VladCher-ger/MyKeyBoard/crkbd/cases/3x5/right.step

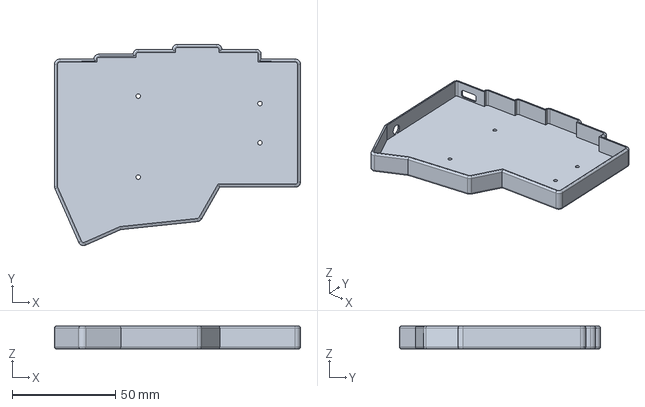
[picture p1: CAD file, 2025-06-12]
crkbd/cases/3x5/right.step
119.3 x 97.6 x 11.1 mm
