VladCher-ger/MyKeyBoard/crkbd/cases/3x6/left.step

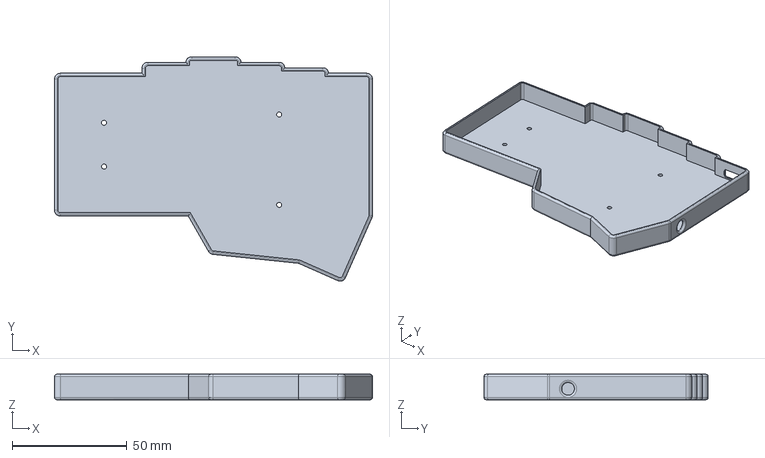
[picture p2: CAD file, 2025-06-12]
crkbd/cases/3x6/left.step
138.3 x 97.6 x 11.1 mm
