VladCher-ger/MyKeyBoard/output/outlines/left.dxf

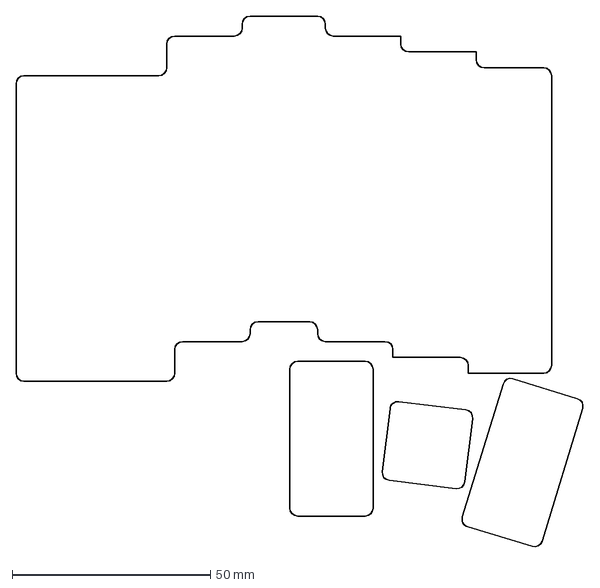
[picture p3: CAD file, 2025-06-10]
output/outlines/left.dxf
143.2 x 134.0 mm
