VladCher-ger/MyKeyBoard/(list of files, cad)

Other CAD files:
crkbd/cases/3x5/left.step
crkbd/cases/3x6/right.step
