VladCher-ger/MyKeyBoard/crkbd/docs/corne-cherry/v4/buildguide_jp.md

# Build Guide
こちらは Corne Cherry v4 のビルドガイドになります。

corne-v4-cherry

## Parts

### Required

| Name | Count | Remarks |
|:---|:---|:---|
| PCB | 1 set | |
| Case | 1 set | |
| Switch plate | 1 set | FR4 厚さ 1.6mm |
| Key switches | 42 - 46 | Cherry MX 互換のみ |
| Keycaps | 42 - 46 | 1u 40 pcs, 1.5u 2 pcs |
| Spacer M2 | 8 | 長さ 7.5 mm |
| Screw M2 | 16 | 長さ 5 mm |
| Rubber cushion | 8 | |
| TRRS (4 poles) cable | 1 | v4.0.0: TRS (3 poles) は非対応<br/> v4.1.0: TRS (3 poles) に対応 |
| Type-C cable | 1 | |

### Optional

| Name | Count | Remarks |
|:---|:---|:---|
| Rotary Encoder | 0 - 4 pieces | EC12互換  |

## Firmware preparation
[docs/firmware/rev4](../../firmware/rev4/firmware_jp.md) を参照してください。

## Build
これは左手側のビルドガイドですが、右手側も手順は同じです。

### 1: キースイッチを取り付ける
plate
plate-side

### オプション: キースイッチの代わりにロータリーエンコーダをはんだ付けする
ロータリーエンコーダを使う場合、下記の図の位置にキースイッチの代わりにロータリーエンコーダを付けることができます。その場合は、裏側からはんだ付けが必要です。

rotary-encoder

### 2: ケースにスペーサーを付ける
case

### 3: 1と2を組み合わせる
switch+case

### 4: ラバークッションを取り付ける
rubber-cushion

### 5: キーキャップを取り付ける
keycap

## 注意
USBケーブルが刺さっている状態でTRRSケーブルの抜き差しが行われると、キーボードのマイコンが破壊されることがあります。  
TRRSケーブルを抜き差しする際は、USBケーブルが外れていることを確認してから行うようにしてください。
