VladCher-ger/MyKeyBoard/crkbd/docs/corne-cherry/v2/buildguide_tilting_tenting_plate_en.md

# Build Guide Tilting / Tenting plate

## Parts

| Name | Count | Remarks |
|:-|:-|:-|
| Completed Corne Cherry | 1 set | Corne Chocolate / 3mm top plate is not supported |
| Middle plate 3mm | 2 sheets | |
| Bottom plate 3mm | 2 sheets | |
| Bolt M5 15mm ~ 50mm | 8 bolts | |
| Nut M5 | 16 pieces | |
| Screw M2 6mm | 10 screws | |
| Screw M2 4mm | 10 screws | |
| Spacer M2 3.5mm | 10 pieces | |
| Cushion rubber | 8 pieces | |

## Advance preparation

lrg_dsc05736

Remove the key switch from the finished Corne Cherry
to separate the body from the top plate.
No other parts are needed.

## Assembly

lrg_dsc05737
lrg_dsc05739

Check the required parts.
Check the dedicated middle plate and bottom plate, and bolts of various lengths.
In addition, use screws, nuts, spacers, etc. (see the parts section for details).

lrg_dsc05742

Secure the middle plate to the top plate with 6mm screws and 3.5mm spacers.

lrg_dsc05744
Secure the OLED display protection plate with 4mm screws.

lrg_dsc05745

Secure the body and bottom plate with 4mm screws.

lrg_dsc05747

Insert an acrylic spacer between the middle plate
and the bottom plate and attach the bolts.

lrg_dsc05748

It is recommended to temporarily assemble the bolts
and adjust the height before completely fixing them with nuts.
Temporary assembly can be done easily by passing only one nut through the bolt.

lrg_dsc05749
lrg_dsc05750

It is completed by firmly fixing it so that it is sandwiched between nuts.

lrg_dsc05761
