VladCher-ger/MyKeyBoard/crkbd/docs/corne-light/v1/buildguide_en.md

# Build Guide

This is the Corne Light v1 build guide.

## Parts

<table>
<thead>
  <tr> <td width = "30%"> Name </td> <td width = "15%"> Count </td> <td> Remarks </td> </tr>
</header>
<tbody>
  <tr>
    <td> PCB </td>
    <td> 1 set </td>
    <td>
      PCB
    </td>
  </tr>
  <tr>
    <td> Top plate </td>
    <td> 2 sheets </td>
    <td>
      top-plates
    </td>
  </tr>
  <tr>
    <td> Bottom plate </td>
    <td> 2 sheets </td>
    <td rowspan = "2">
      bottom-plates
    </td>
  </tr>
  <tr>
    <td> ProMicro protective plate </td>
    <td> 2 sheets </td>
  </tr>
  <tr>
    <td> diode </td>
    <td> 42 </td>
    <td>
      diodes
    </td>
  </tr>
  <tr>
    <td> Spacer M2 7.5mm </td>
    <td> 10 </td>
    <td rowspan = "3">
      screws
    </td>
  </tr>
  <tr>
    <td> Spacer M2 9mm </td>
    <td> 4 </td>
  </tr>
  <tr>
    <td> Screw M2 4mm </td>
    <td> 28 </td>
  </tr>
  <tr>
    <td> TRRS jack </td>
    <td> 2 </td>
    <td rowspan = "3">
      jacks
    </td>
  </tr>
  <tr>
    <td> Reset switch </td>
    <td> 2 </td>
  </tr>
  <tr>
    <td> Rubber feet </td>
    <td> 8 </td>
  </tr>
  <tr>
    <td> ProMicro (with conthrough) </td>
    <td> 2 </td>
    <td>
      <a href="https://yushakobo.jp/shop/promicro-spring-pinheader/"> https://yushakobo.jp/shop/promicro-spring-pinheader/ </a>
    </td>
  </tr>
  <tr>
    <td> OLED module (with pin socket) </td>
    <td> 2 </td>
    <td>
      <a href="https://yushakobo.jp/shop/oled/"> https://yushakobo.jp/shop/oled/ </a>
    </td>
  </tr>
  <tr>
    <td> key switch </td>
    <td> 42 </td>
    <td> </td>
  </tr>
  <tr>
    <td> keycap </td>
    <td> 42 </td>
    <td> </td>
  </tr>
  <tr>
    <td> TRRS cable </td>
    <td> 1 </td>
    <td> TRS cable is also acceptable </td>
  </tr>
  <tr>
    <td> USB cable </td>
    <td> 1 </td>
    <td> </td>
  </tr>
</tbody>
</table>

## Advance preparation

If you build the firmware yourself,
it takes time to prepare the environment,
so it is recommended to start first. \
See [docs/firmware/rev1](../../firmware/rev1/firmware_en.md)
for more information.

## Implementation

### PCB disconnection

Check the front and back and separate the left and right PCBs
(the photo is the front).

assembly-pcb

This is a jig for bending the legs of a diode.
Separate it if necessary.

assembly-tool-of-diodes

* Some versions do not have a jig.

### Diodes

First, bend the legs of the reed type diode.

* You can clean it by bending it one by one as shown in the picture,
  but it is more efficient to bend multiple pieces at the same time
  while connected to the tape.

assembly-diodes-1

Attach the diode with the bent leg to the specified position.

assembly-diodes-2

The diode has an orientation and is installed as shown in the photo.

* All the diodes to be attached are in the same orientation.

assembly-diodes-3

You can attach it neatly by fixing it with masking tape.

assembly-diodes-4

Solder from the back side.

assembly-diodes-5

If you are fixing with masking tape,
cutting your legs to the limit like this will make soldering easier.

assembly-diodes-6

With 21 one-handed and two-handed he installs 42 diodes.

assembly-diodes-7

### TRRS jack, reset switch, pin socket

Install in the specified position.

* Install the right hand side in the same position
  (be careful of mistakes on the front and back).

assembly-jacks-resets-pinsockets-1

### ProMicro, OLED module

Install his ProMicro and his OLED module by referring to the [Helix Build Guide](
https://github.com/MakotoKurauchi/helix/blob/master/Doc/buildguide_en.md#pro-micro).

assembly-promicro-oled

### Firmware

Write the firmware to ProMicro by referring to the following. \
[docs/firmware/rev1](../../firmware/rev1/firmware_en.md)

### Operation check

To check the operation,
connect the left hand side to the PC with a USB cable,
and connect the left hand side and the right hand side with the TRRS cable.
Since there may be defects such as jacks,
be sure to connect the left and right instead of one by one
before checking the operation.

* Since the switch is not attached,
  check the operation with tweezers as shown in the photo.

check

### Top plate, key switch

Attach the key switch to the top plate as shown in the picture.

* Be careful of the direction of the key switch.

assembly-keyswitches-1

We recommend using a 3-pin key switch.

* Even when using 5 pins, the plastic legs can be separated to make 3 pins.

assembly-keyswitches-2

Solder so that there is no gap between the switch and the PCB.

assembly-keyswitches-3
assembly-keyswitches-4

### ProMicro Protective Plate, Bottom Plate

Attach his ProMicro protective plate using an M2 9mm spacer.

assembly-plates-1

Install the bottom plate using the M2 7.5mm spacer.

assembly-plates-2

Attach the rubber feet to the four corners.

assembly-plates-3

## Complete

Attach the keycap and you're done.

assembly-finished-1
assembly-finished-2
