VladCher-ger/MyKeyBoard/crkbd/pcbs/corne-cherry/hotswap/corne-cherry.kicad_pcb

## KiCad design crkbd/pcbs/corne-cherry/hotswap/corne-cherry.kicad_pcb (2025-06-12)

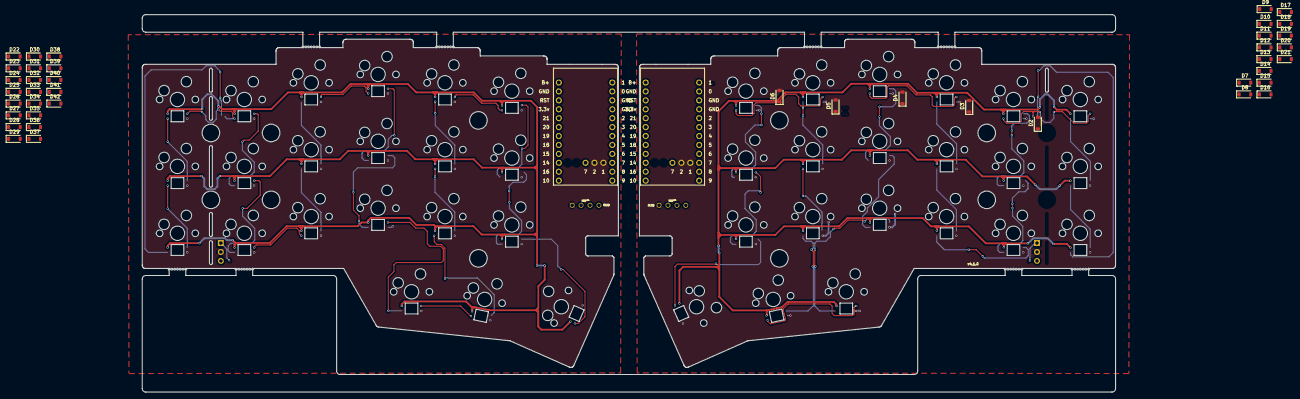
[picture p45: board corne-cherry.kicad_pcb from above]

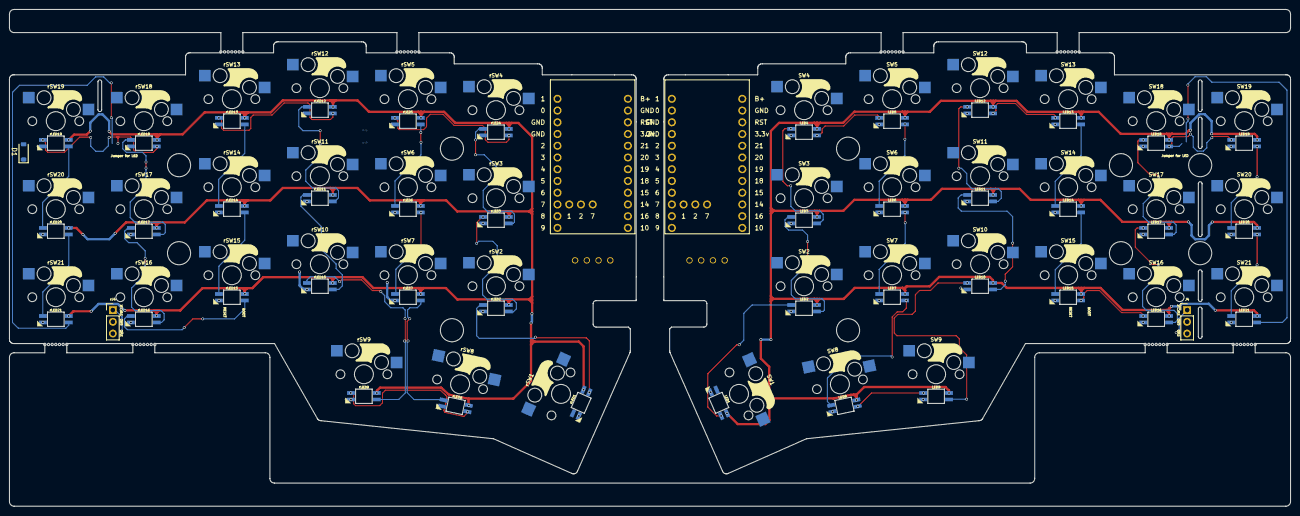
[picture p46: board corne-cherry.kicad_pcb from below]

Board: 2 copper layers, 277.2 x 107.5 mm, 140 parts (89 on the bottom side), 100 nets.

Parts:
BT1, BT2, BT3, BT4: Breakaway Tabs; Breakaway_Tabs
D1, D2, D3, D4, D5, D6, D7, D8, D9, D10, D11, D12, D13, D14, D15, D16, D17, D18, D19, D20, D21, D22, D23, D24, D25, D26, D27, D28, D29, D30, D31, D32, D33, D34, D35, D36, D37, D38, D39, D40, D41, D42: Diode; D_SOD-123
J3: Conn_01x04; OLED
J4: Conn_01x03; PinHeader_1x03_P2.54mm_Vertical
LED1, LED2, LED3, LED4, LED5, LED6, LED7, LED8, LED9, LED10, LED11, LED12, LED13, LED14, LED15, LED16, LED17, LED18, LED19, LED20, LED21: YS-SK6812MINI-E
SW1: SW_Push; keyswitch_cherrymx_hotswap_1.5u
SW2, SW3, SW4, SW5, SW6, SW7, SW8, SW9, SW10, SW11, SW12, SW13, SW14, SW15, SW16, SW17, SW18, SW19, SW20, SW21: SW_Push; keyswitch_cherrymx_hotswap_1u
U1, U2: Nice_Nano_V2
rBT1, rBT2, rBT3, rBT4: Breakaway Tabs; Breakaway_Tabs
rJ3: Conn_01x04; OLED
rJ4: Conn_01x03; PinHeader_1x03_P2.54mm_Vertical
rLED1, rLED2, rLED3, rLED4, rLED5, rLED6, rLED7, rLED8, rLED9, rLED10, rLED11, rLED12, rLED13, rLED14, rLED15, rLED16, rLED17, rLED18, rLED19, rLED20, rLED21: YS-SK6812MINI-E
rSW1: SW_Push; keyswitch_cherrymx_hotswap_1.5u
rSW2, rSW3, rSW4, rSW5, rSW6, rSW7, rSW8, rSW9, rSW10, rSW11, rSW12, rSW13, rSW14, rSW15, rSW16, rSW17, rSW18, rSW19, rSW20, rSW21: SW_Push; keyswitch_cherrymx_hotswap_1u

Connections:
C0: rSW19.1, rSW20.1, rSW21.1
C1: rSW16.1, rSW17.1, rSW18.1
C2: rSW13.1, rSW14.1, rSW15.1
C3: rSW9.1, rSW10.1, rSW11.1, rSW12.1
C4: rSW5.1, rSW6.1, rSW7.1, rSW8.1
C5: rSW1.1, rSW2.1, rSW3.1, rSW4.1
CL0: SW19.1, SW20.1, SW21.1
CL1: SW16.1, SW17.1, SW18.1
CL2: SW13.1, SW14.1, SW15.1
CL3: SW9.1, SW10.1, SW11.1, SW12.1
CL4: SW5.1, SW6.1, SW7.1, SW8.1
CL5: SW1.1, SW2.1, SW3.1, SW4.1
GND: J3.4, J4.2, LED1.3 (VSS), LED2.3 (VSS), LED3.3 (VSS), LED4.3 (VSS), LED5.3 (VSS), LED6.3 (VSS), LED7.3 (VSS), LED8.3 (VSS), LED9.3 (VSS), LED10.3 (VSS), LED11.3 (VSS), LED12.3 (VSS), LED13.3 (VSS), LED14.3 (VSS), LED15.3 (VSS), LED16.3 (VSS), LED17.3 (VSS), LED18.3 (VSS), LED19.3 (VSS), LED20.3 (VSS), LED21.3 (VSS)
GNDR: U1.3 (GND), U1.4 (GND), U1.23 (GND), rJ3.4, rJ4.2, rLED1.3 (VSS), rLED2.3 (VSS), rLED3.3 (VSS), rLED4.3 (VSS), rLED5.3 (VSS), rLED6.3 (VSS), rLED7.3 (VSS), rLED8.3 (VSS), rLED9.3 (VSS), rLED10.3 (VSS), rLED11.3 (VSS), rLED12.3 (VSS), rLED13.3 (VSS), rLED14.3 (VSS), rLED15.3 (VSS), rLED16.3 (VSS), rLED17.3 (VSS), rLED18.3 (VSS), rLED19.3 (VSS), rLED20.3 (VSS), rLED21.3 (VSS)
unnamed: D1.2 (A), rSW19.2
unnamed: D2.2 (A), rSW18.2
unnamed: D3.2 (A), rSW13.2
unnamed: D4.2 (A), rSW12.2
unnamed: D5.2 (A), rSW5.2
unnamed: D6.2 (A), rSW4.2
unnamed: D7.2 (A), rSW20.2
unnamed: D8.2 (A), rSW17.2
unnamed: D9.2 (A), rSW14.2
unnamed: D10.2 (A), rSW11.2
unnamed: D11.2 (A), rSW6.2
unnamed: D12.2 (A), rSW3.2
unnamed: D19.2 (A), rSW9.2
unnamed: D20.2 (A), rSW8.2
unnamed: D21.2 (A), rSW1.2
unnamed: D22.2 (A), SW19.2
unnamed: D23.2 (A), SW18.2
unnamed: D24.2 (A), SW13.2
unnamed: D25.2 (A), SW12.2
unnamed: D26.2 (A), SW5.2
unnamed: D27.2 (A), SW4.2
unnamed: D28.2 (A), SW20.2
unnamed: D29.2 (A), SW17.2
unnamed: D30.2 (A), SW14.2
unnamed: D31.2 (A), SW11.2
unnamed: D32.2 (A), SW6.2
unnamed: D33.2 (A), SW3.2
unnamed: D34.2 (A), SW21.2
unnamed: D35.2 (A), SW16.2
unnamed: D36.2 (A), SW15.2
unnamed: D37.2 (A), SW10.2
unnamed: D38.2 (A), SW7.2
unnamed: D39.2 (A), SW2.2
unnamed: D40.2 (A), SW9.2
unnamed: D41.2 (A), SW8.2
unnamed: D42.2 (A), SW1.2
unnamed: LED1.2 (DOUT), LED2.4 (DIN)
unnamed: LED1.1 (VDD), LED2.1 (VDD), LED3.1 (VDD), LED4.1 (VDD), LED5.1 (VDD), LED6.1 (VDD), LED7.1 (VDD), LED8.1 (VDD), LED9.1 (VDD), LED10.1 (VDD), LED11.1 (VDD), LED12.1 (VDD), LED13.1 (VDD), LED14.1 (VDD), LED15.1 (VDD), LED16.1 (VDD), LED17.1 (VDD), LED18.1 (VDD), LED19.1 (VDD), LED20.1 (VDD), LED21.1 (VDD)
unnamed: LED2.2 (DOUT), LED3.4 (DIN)
unnamed: LED3.2 (DOUT), LED4.4 (DIN)
unnamed: LED4.2 (DOUT), LED5.4 (DIN)
unnamed: LED5.2 (DOUT), LED6.4 (DIN)
unnamed: LED6.2 (DOUT), LED7.4 (DIN)
unnamed: LED7.2 (DOUT), LED8.4 (DIN)
unnamed: LED8.2 (DOUT), LED9.4 (DIN)
unnamed: LED9.2 (DOUT), LED10.4 (DIN)
unnamed: LED10.2 (DOUT), LED11.4 (DIN)
unnamed: LED11.2 (DOUT), LED12.4 (DIN)
unnamed: LED12.2 (DOUT), LED13.4 (DIN)
unnamed: LED13.2 (DOUT), LED14.4 (DIN)
unnamed: LED14.2 (DOUT), LED15.4 (DIN)
unnamed: LED15.2 (DOUT), LED16.4 (DIN)
unnamed: LED16.2 (DOUT), LED17.4 (DIN)
unnamed: LED17.2 (DOUT), LED18.4 (DIN)
unnamed: LED18.2 (DOUT), LED19.4 (DIN)
unnamed: LED19.2 (DOUT), LED20.4 (DIN)
unnamed: LED20.2 (DOUT), LED21.4 (DIN)
unnamed: rLED1.2 (DOUT), rLED2.4 (DIN)
unnamed: rLED1.1 (VDD), rLED2.1 (VDD), rLED3.1 (VDD), rLED4.1 (VDD), rLED5.1 (VDD), rLED6.1 (VDD), rLED7.1 (VDD), rLED8.1 (VDD), rLED9.1 (VDD), rLED10.1 (VDD), rLED11.1 (VDD), rLED12.1 (VDD), rLED13.1 (VDD), rLED14.1 (VDD), rLED15.1 (VDD), rLED16.1 (VDD), rLED17.1 (VDD), rLED18.1 (VDD), rLED19.1 (VDD), rLED20.1 (VDD), rLED21.1 (VDD)
unnamed: rLED2.2 (DOUT), rLED3.4 (DIN)
unnamed: rLED3.2 (DOUT), rLED4.4 (DIN)
unnamed: rLED4.2 (DOUT), rLED5.4 (DIN)
unnamed: rLED5.2 (DOUT), rLED6.4 (DIN)
unnamed: rLED6.2 (DOUT), rLED7.4 (DIN)
unnamed: rLED7.2 (DOUT), rLED8.4 (DIN)
unnamed: rLED8.2 (DOUT), rLED9.4 (DIN)
unnamed: rLED9.2 (DOUT), rLED10.4 (DIN)
unnamed: rLED10.2 (DOUT), rLED11.4 (DIN)
unnamed: rLED11.2 (DOUT), rLED12.4 (DIN)
unnamed: rLED12.2 (DOUT), rLED13.4 (DIN)
unnamed: rLED13.2 (DOUT), rLED14.4 (DIN)
unnamed: rLED14.2 (DOUT), rLED15.4 (DIN)
unnamed: rLED15.2 (DOUT), rLED16.4 (DIN)
unnamed: rLED16.2 (DOUT), rLED17.4 (DIN)
unnamed: rLED17.2 (DOUT), rLED18.4 (DIN)
unnamed: rLED18.2 (DOUT), rLED19.4 (DIN)
unnamed: rLED19.2 (DOUT), rLED20.4 (DIN)
unnamed: rLED20.2 (DOUT), rLED21.4 (DIN)
R0: D1.1 (K), D2.1 (K), D3.1 (K), D4.1 (K), D5.1 (K), D6.1 (K)
R1: D7.1 (K), D8.1 (K), D9.1 (K), D10.1 (K), D11.1 (K), D12.1 (K)
R2: D13.1 (K), D14.1 (K), D15.1 (K), D16.1 (K), D17.1 (K), D18.1 (K)
R3: D19.1 (K), D20.1 (K), D21.1 (K)
RL0: D22.1 (K), D23.1 (K), D24.1 (K), D25.1 (K), D26.1 (K), D27.1 (K)
RL1: D28.1 (K), D29.1 (K), D30.1 (K), D31.1 (K), D32.1 (K), D33.1 (K)
RL2: D34.1 (K), D35.1 (K), D36.1 (K), D37.1 (K), D38.1 (K), D39.1 (K)
RL3: D40.1 (K), D41.1 (K), D42.1 (K)
