VladCher-ger/MyKeyBoard/Schaltplan/left.kicad_pcb

## KiCad design Schaltplan/left.kicad_pcb (2025-06-11)

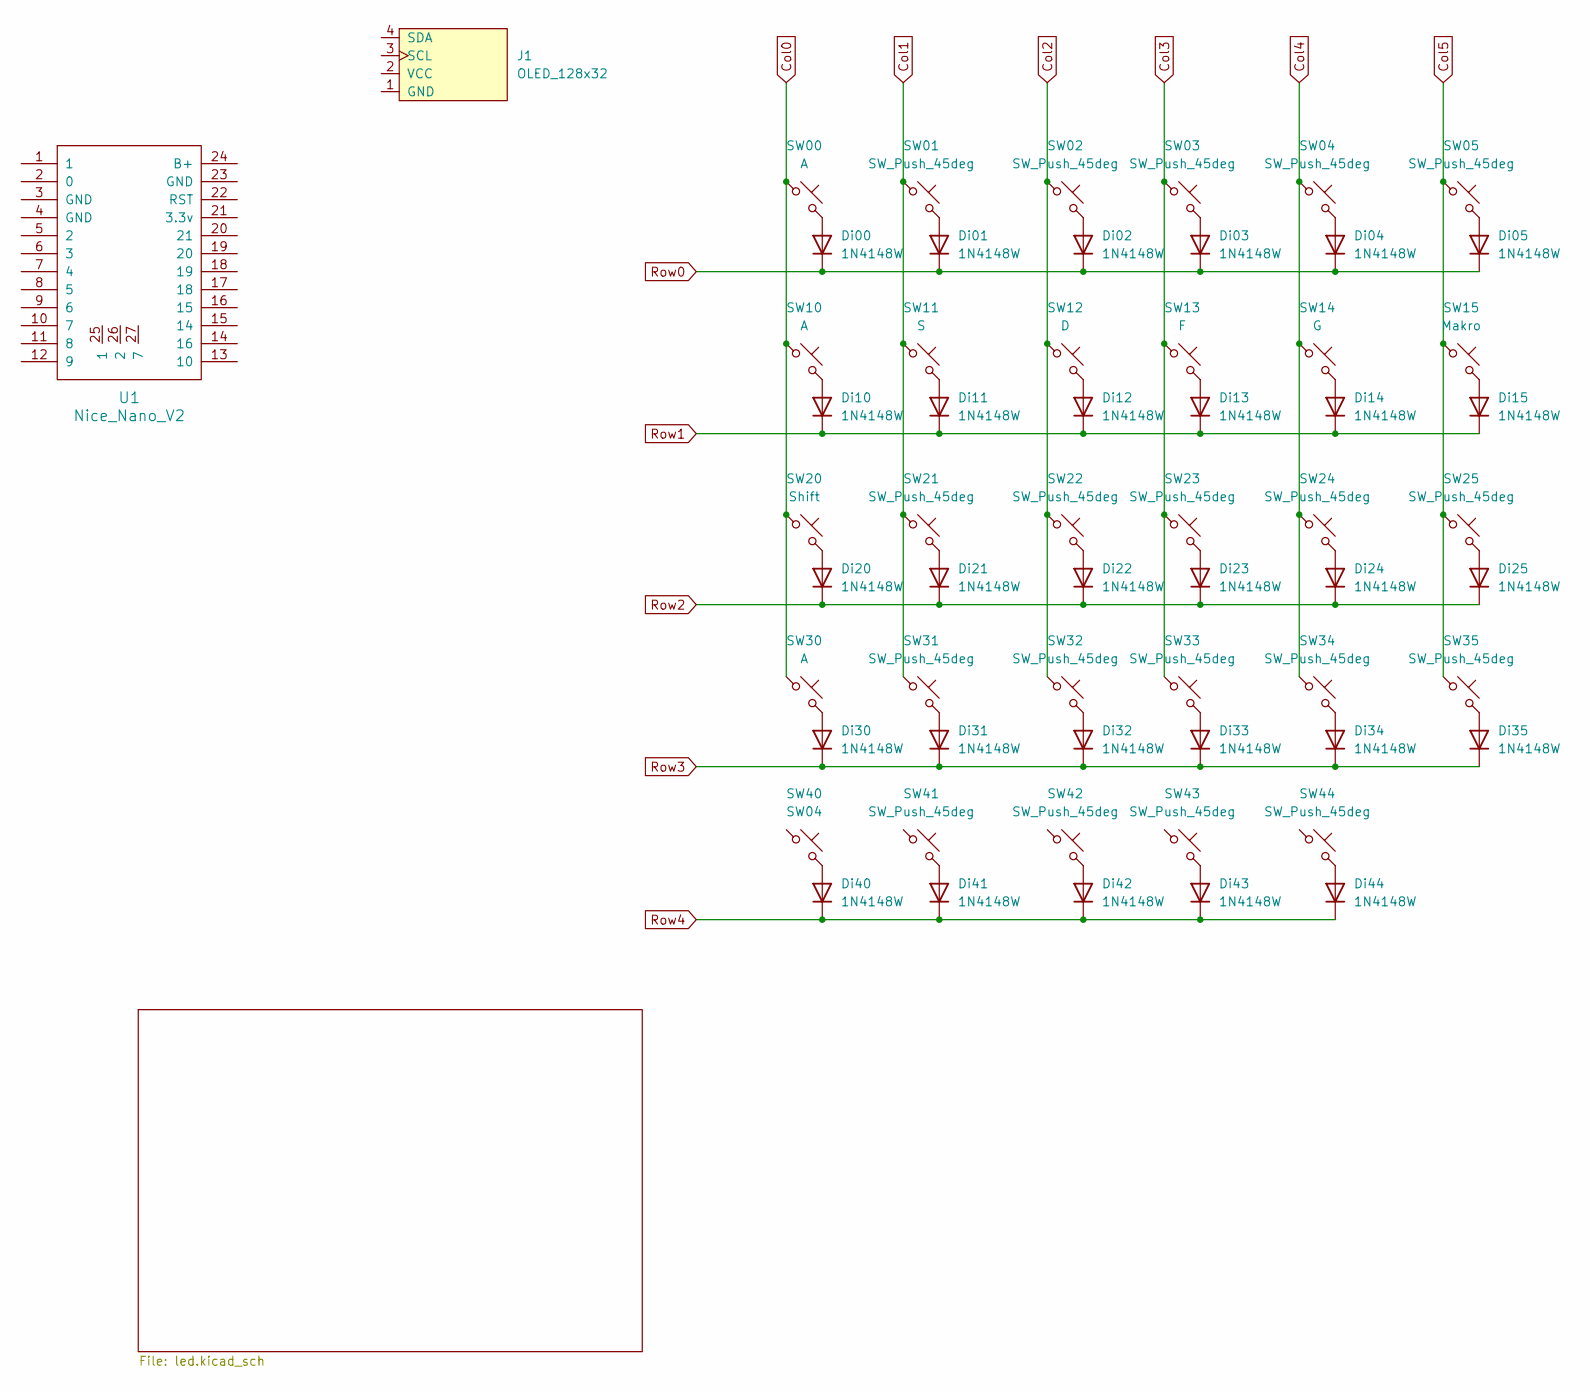
[picture p47: schematic untitled.kicad_sch, left]

Parts:
Di00, Di01, Di02, Di03, Di04, Di05, Di10, Di11, Di12, Di13, Di14, Di15, Di20, Di21, Di22, Di23, Di24, Di25, Di30, Di31, Di32, Di33, Di34, Di35, Di40, Di41, Di42, Di43, Di44: 1N4148W; D_SOD-123
J1: OLED_128x32
SW00, SW10, SW30: A; Hotswap_MX_1.00u
SW01, SW02, SW03, SW04, SW05, SW21, SW22, SW23, SW24, SW25, SW31, SW32, SW33, SW34, SW35, SW41, SW43, SW44: SW_Push_45deg; Hotswap_MX_1.00u
SW11: S; Hotswap_MX_1.00u
SW12: D; Hotswap_MX_1.00u
SW13: F; Hotswap_MX_1.00u
SW14: G; Hotswap_MX_1.00u
SW15: Makro; Hotswap_MX_1.00u
SW20: Shift; Hotswap_MX_1.00u
SW40: SW04; Hotswap_MX_1.00u
SW42: SW_Push_45deg; Hotswap_MX_1.75u
U1: Nice_Nano_V2

Connections:
Col0: SW00.1, SW10.1, SW20.1, SW30.1
Col1: SW01.1, SW11.1, SW21.1, SW31.1
Col2: SW02.1, SW12.1, SW22.1, SW32.1
Col3: SW03.1, SW13.1, SW23.1, SW33.1
Col4: SW04.1, SW14.1, SW24.1, SW34.1
Col5: SW05.1, SW15.1, SW25.1, SW35.1
unnamed: Di00.2 (A), SW00.2
unnamed: Di01.2 (A), SW01.2
unnamed: Di02.2 (A), SW02.2
unnamed: Di03.2 (A), SW03.2
unnamed: Di04.2 (A), SW04.2
unnamed: Di05.2 (A), SW05.2
unnamed: Di10.2 (A), SW10.2
unnamed: Di11.2 (A), SW11.2
unnamed: Di12.2 (A), SW12.2
unnamed: Di13.2 (A), SW13.2
unnamed: Di14.2 (A), SW14.2
unnamed: Di15.2 (A), SW15.2
unnamed: Di20.2 (A), SW20.2
unnamed: Di21.2 (A), SW21.2
unnamed: Di22.2 (A), SW22.2
unnamed: Di23.2 (A), SW23.2
unnamed: Di24.2 (A), SW24.2
unnamed: Di25.2 (A), SW25.2
unnamed: Di30.2 (A), SW30.2
unnamed: Di31.2 (A), SW31.2
unnamed: Di32.2 (A), SW32.2
unnamed: Di33.2 (A), SW33.2
unnamed: Di34.2 (A), SW34.2
unnamed: Di35.2 (A), SW35.2
unnamed: Di40.2 (A), SW40.2
unnamed: Di41.2 (A), SW41.2
unnamed: Di42.2 (A), SW42.2
unnamed: Di43.2 (A), SW43.2
unnamed: Di44.2 (A), SW44.2
Row0: Di00.1 (K), Di01.1 (K), Di02.1 (K), Di03.1 (K), Di04.1 (K), Di05.1 (K)
Row1: Di10.1 (K), Di11.1 (K), Di12.1 (K), Di13.1 (K), Di14.1 (K), Di15.1 (K)
Row2: Di20.1 (K), Di21.1 (K), Di22.1 (K), Di23.1 (K), Di24.1 (K), Di25.1 (K)
Row3: Di30.1 (K), Di31.1 (K), Di32.1 (K), Di33.1 (K), Di34.1 (K), Di35.1 (K)
Row4: Di40.1 (K), Di41.1 (K), Di42.1 (K), Di43.1 (K), Di44.1 (K)

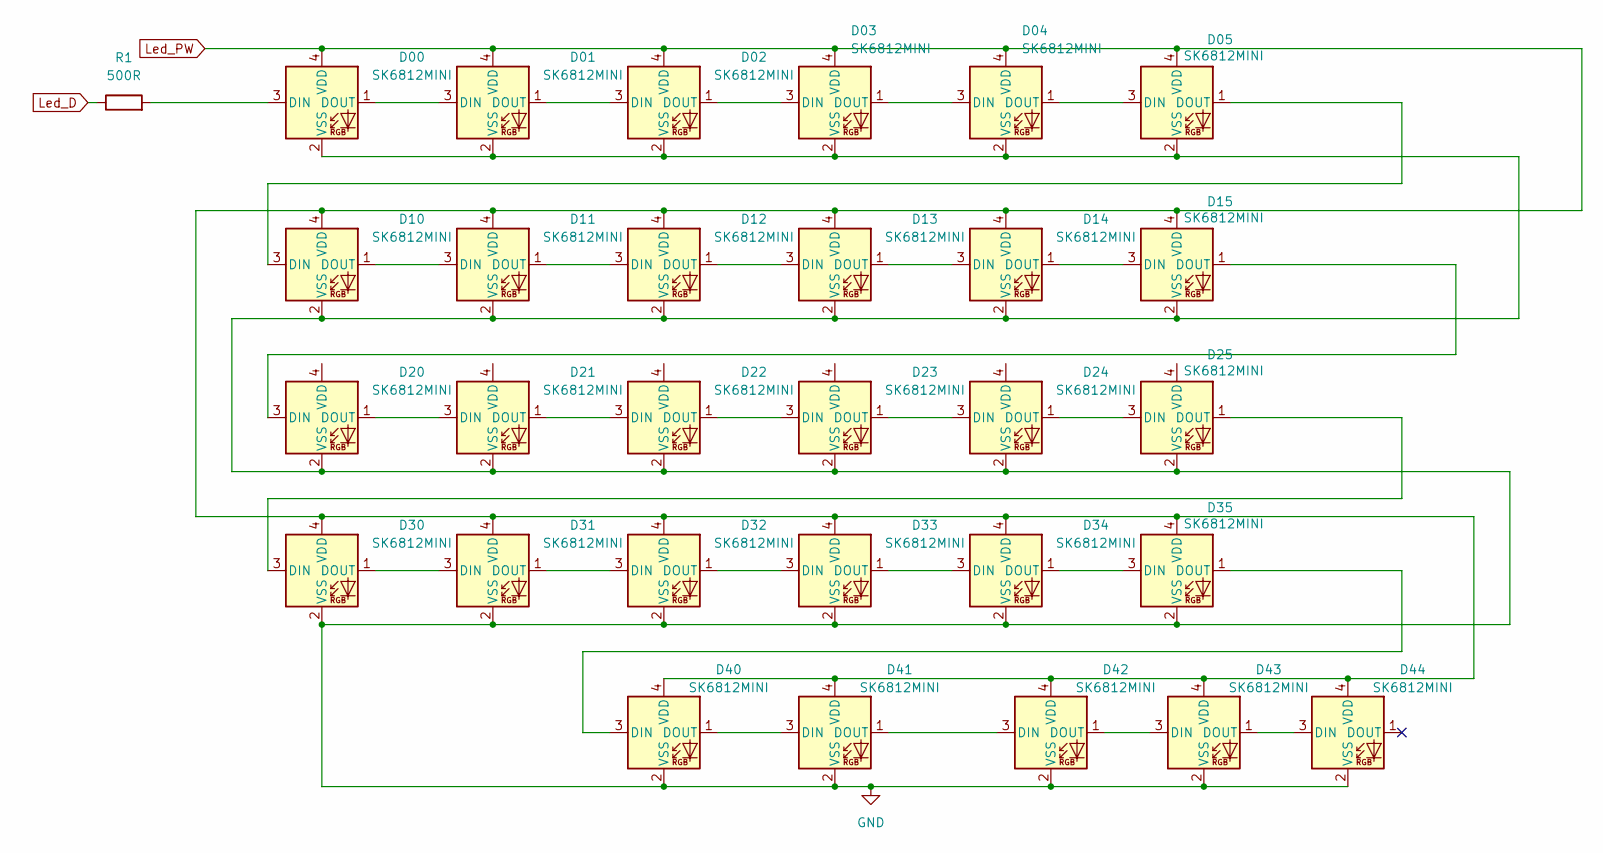
[picture p48: schematic led.kicad_sch]

Parts:
D00, D01, D02, D03, D04, D05, D10, D11, D12, D13, D14, D15, D20, D21, D22, D23, D24, D25, D30, D31, D32, D33, D34, D35, D40, D41, D42, D43, D44: SK6812MINI; SK6812-MINI-E
R1: 500R; R_Axial_DIN0414_L11.9mm_D4.5mm_P15.24mm_Horizontal

Connections:
GND: D00.2 (VSS), D01.2 (VSS), D02.2 (VSS), D03.2 (VSS), D04.2 (VSS), D05.2 (VSS), D10.2 (VSS), D11.2 (VSS), D12.2 (VSS), D13.2 (VSS), D14.2 (VSS), D15.2 (VSS), D20.2 (VSS), D21.2 (VSS), D22.2 (VSS), D23.2 (VSS), D24.2 (VSS), D25.2 (VSS), D30.2 (VSS), D31.2 (VSS), D32.2 (VSS), D33.2 (VSS), D34.2 (VSS), D35.2 (VSS), D40.2 (VSS), D41.2 (VSS), D42.2 (VSS), D43.2 (VSS), D44.2 (VSS)
Led_D: R1.1
Led_PW: D00.4 (VDD), D01.4 (VDD), D02.4 (VDD), D03.4 (VDD), D04.4 (VDD), D05.4 (VDD), D10.4 (VDD), D11.4 (VDD), D12.4 (VDD), D13.4 (VDD), D14.4 (VDD), D15.4 (VDD), D30.4 (VDD), D31.4 (VDD), D32.4 (VDD), D33.4 (VDD), D34.4 (VDD), D35.4 (VDD), D40.4 (VDD), D41.4 (VDD), D42.4 (VDD), D43.4 (VDD), D44.4 (VDD)
unnamed: D00.3 (DIN), R1.2
unnamed: D00.1 (DOUT), D01.3 (DIN)
unnamed: D01.1 (DOUT), D02.3 (DIN)
unnamed: D02.1 (DOUT), D03.3 (DIN)
unnamed: D03.1 (DOUT), D04.3 (DIN)
unnamed: D04.1 (DOUT), D05.3 (DIN)
unnamed: D05.1 (DOUT), D10.3 (DIN)
unnamed: D10.1 (DOUT), D11.3 (DIN)
unnamed: D11.1 (DOUT), D12.3 (DIN)
unnamed: D12.1 (DOUT), D13.3 (DIN)
unnamed: D13.1 (DOUT), D14.3 (DIN)
unnamed: D14.1 (DOUT), D15.3 (DIN)
unnamed: D15.1 (DOUT), D20.3 (DIN)
unnamed: D20.1 (DOUT), D21.3 (DIN)
unnamed: D21.1 (DOUT), D22.3 (DIN)
unnamed: D22.1 (DOUT), D23.3 (DIN)
unnamed: D23.1 (DOUT), D24.3 (DIN)
unnamed: D24.1 (DOUT), D25.3 (DIN)
unnamed: D25.1 (DOUT), D30.3 (DIN)
unnamed: D30.1 (DOUT), D31.3 (DIN)
unnamed: D31.1 (DOUT), D32.3 (DIN)
unnamed: D32.1 (DOUT), D33.3 (DIN)
unnamed: D33.1 (DOUT), D34.3 (DIN)
unnamed: D34.1 (DOUT), D35.3 (DIN)
unnamed: D35.1 (DOUT), D40.3 (DIN)
unnamed: D40.1 (DOUT), D41.3 (DIN)
unnamed: D41.1 (DOUT), D42.3 (DIN)
unnamed: D42.1 (DOUT), D43.3 (DIN)
unnamed: D43.1 (DOUT), D44.3 (DIN)

Board: 2 copper layers, 90 parts (60 on the bottom side), 71 nets, no tracks yet.
