VladCher-ger/MyKeyBoard/output/pcbs/left.kicad_pcb

## KiCad design output/pcbs/left.kicad_pcb (2025-06-10)

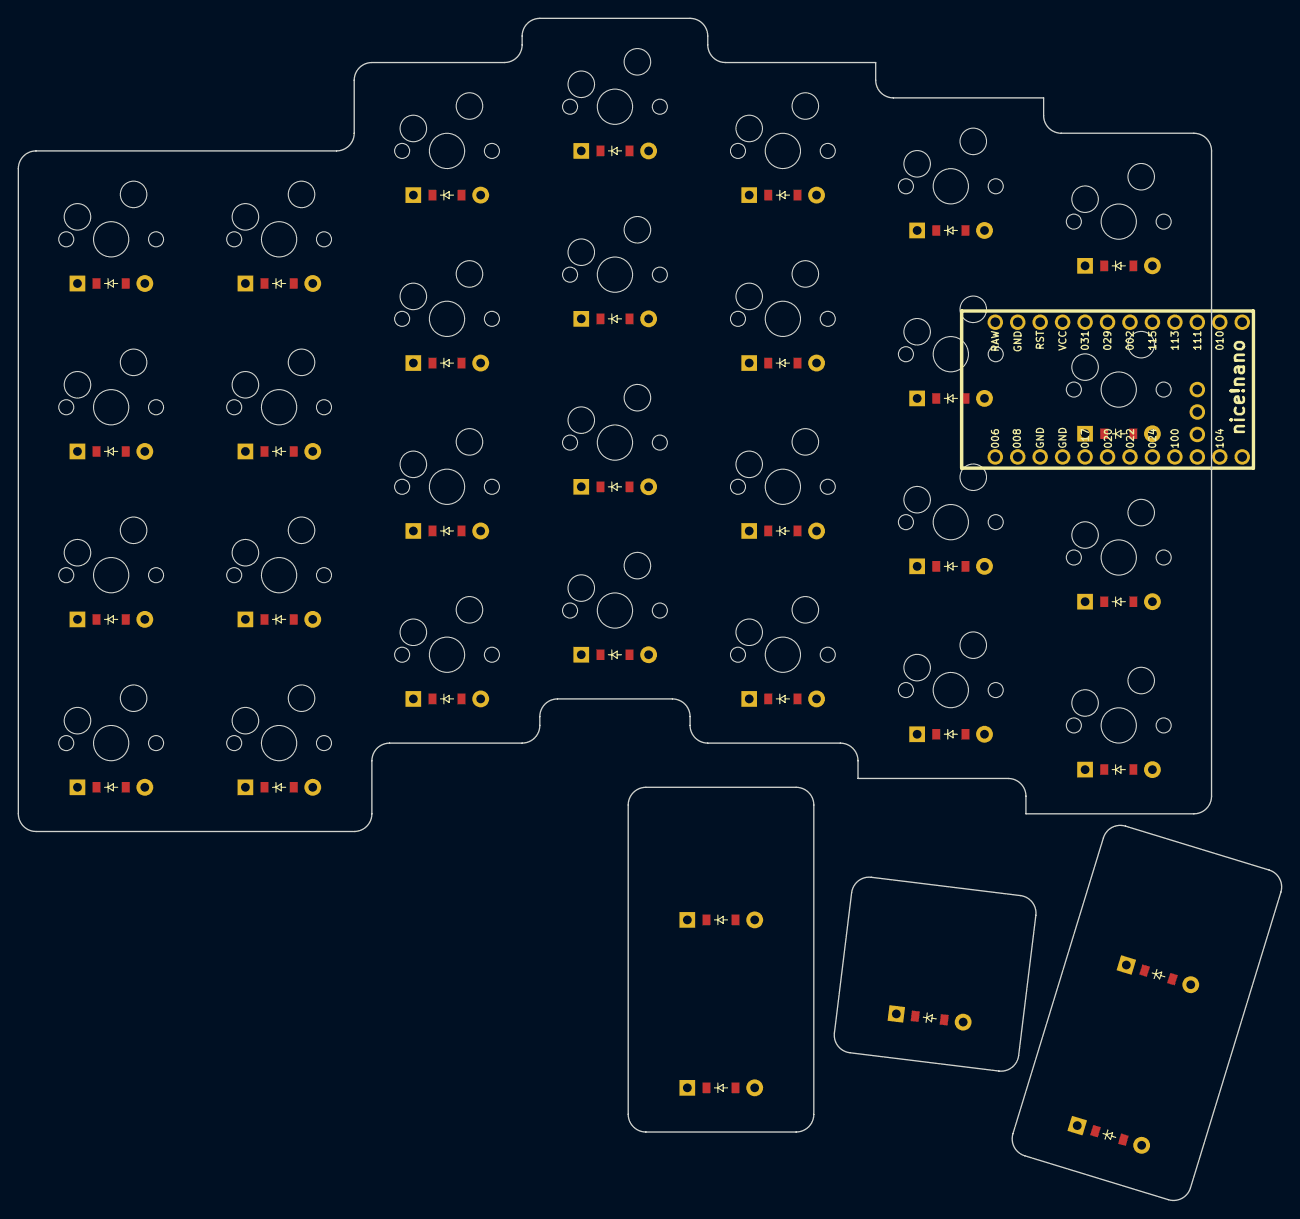
[picture p49: board output/pcbs/left.kicad_pcb from above]

Board: 2 copper layers, 142.9 x 133.7 mm, 62 parts (0 on the bottom side), 36 nets, no tracks yet.

Parts:
D1, D2, D3, D4, D5, D6, D7, D8, D9, D10, D11, D12, D13, D14, D15, D16, D17, D18, D19, D20, D21, D22, D23, D24, D25, D26, D27, D28, D29, D30, D31, D32, D33: ComboDiode
MCU1: nice_nano
S1, S2, S3, S4, S5, S6, S7, S8, S9, S10, S11, S12, S13, S14, S15, S16, S17, S18, S19, S20, S21, S22, S23, S24, S25, S26, S27, S28: MX

Connections:
GND: MCU1.3, MCU1.4, MCU1.23
P006: MCU1.1, S1.1, S2.1, S3.1, S4.1
P017: MCU1.5, S5.1, S6.1, S7.1, S8.1
P020: MCU1.6, S9.1, S10.1, S11.1, S12.1
P022: MCU1.7, S13.1, S14.1, S15.1, S16.1
P024: MCU1.8, S17.1, S18.1, S19.1, S20.1
P100: MCU1.9, S21.1, S22.1, S23.1, S24.1
P104: MCU1.11, S25.1, S26.1, S27.1, S28.1
index_bottom: D17.2, S17.2
index_home: D18.2, S18.2
index_number: D20.2, S20.2
index_top: D19.2, S19.2
inner_bottom: D21.2, S21.2
inner_home: D22.2, S22.2
inner_number: D24.2, S24.2
inner_top: D23.2, S23.2
makros_bottom: D25.2, S25.2
makros_home: D26.2, S26.2
makros_number: D28.2, S28.2
makros_top: D27.2, S27.2
middle_bottom: D13.2, S13.2
middle_home: D14.2, S14.2
middle_number: D16.2, S16.2
middle_top: D15.2, S15.2
outer_bottom: D1.2, S1.2
outer_home: D2.2, S2.2
outer_number: D4.2, S4.2
outer_top: D3.2, S3.2
pinky_bottom: D5.2, S5.2
pinky_home: D6.2, S6.2
pinky_number: D8.2, S8.2
pinky_top: D7.2, S7.2
ring_bottom: D9.2, S9.2
ring_home: D10.2, S10.2
ring_number: D12.2, S12.2
ring_top: D11.2, S11.2
