VladCher-ger/MyKeyBoard/crkbd/pcbs/common/left.kicad_sch

## KiCad design crkbd/pcbs/common/left.kicad_sch (2025-06-12)

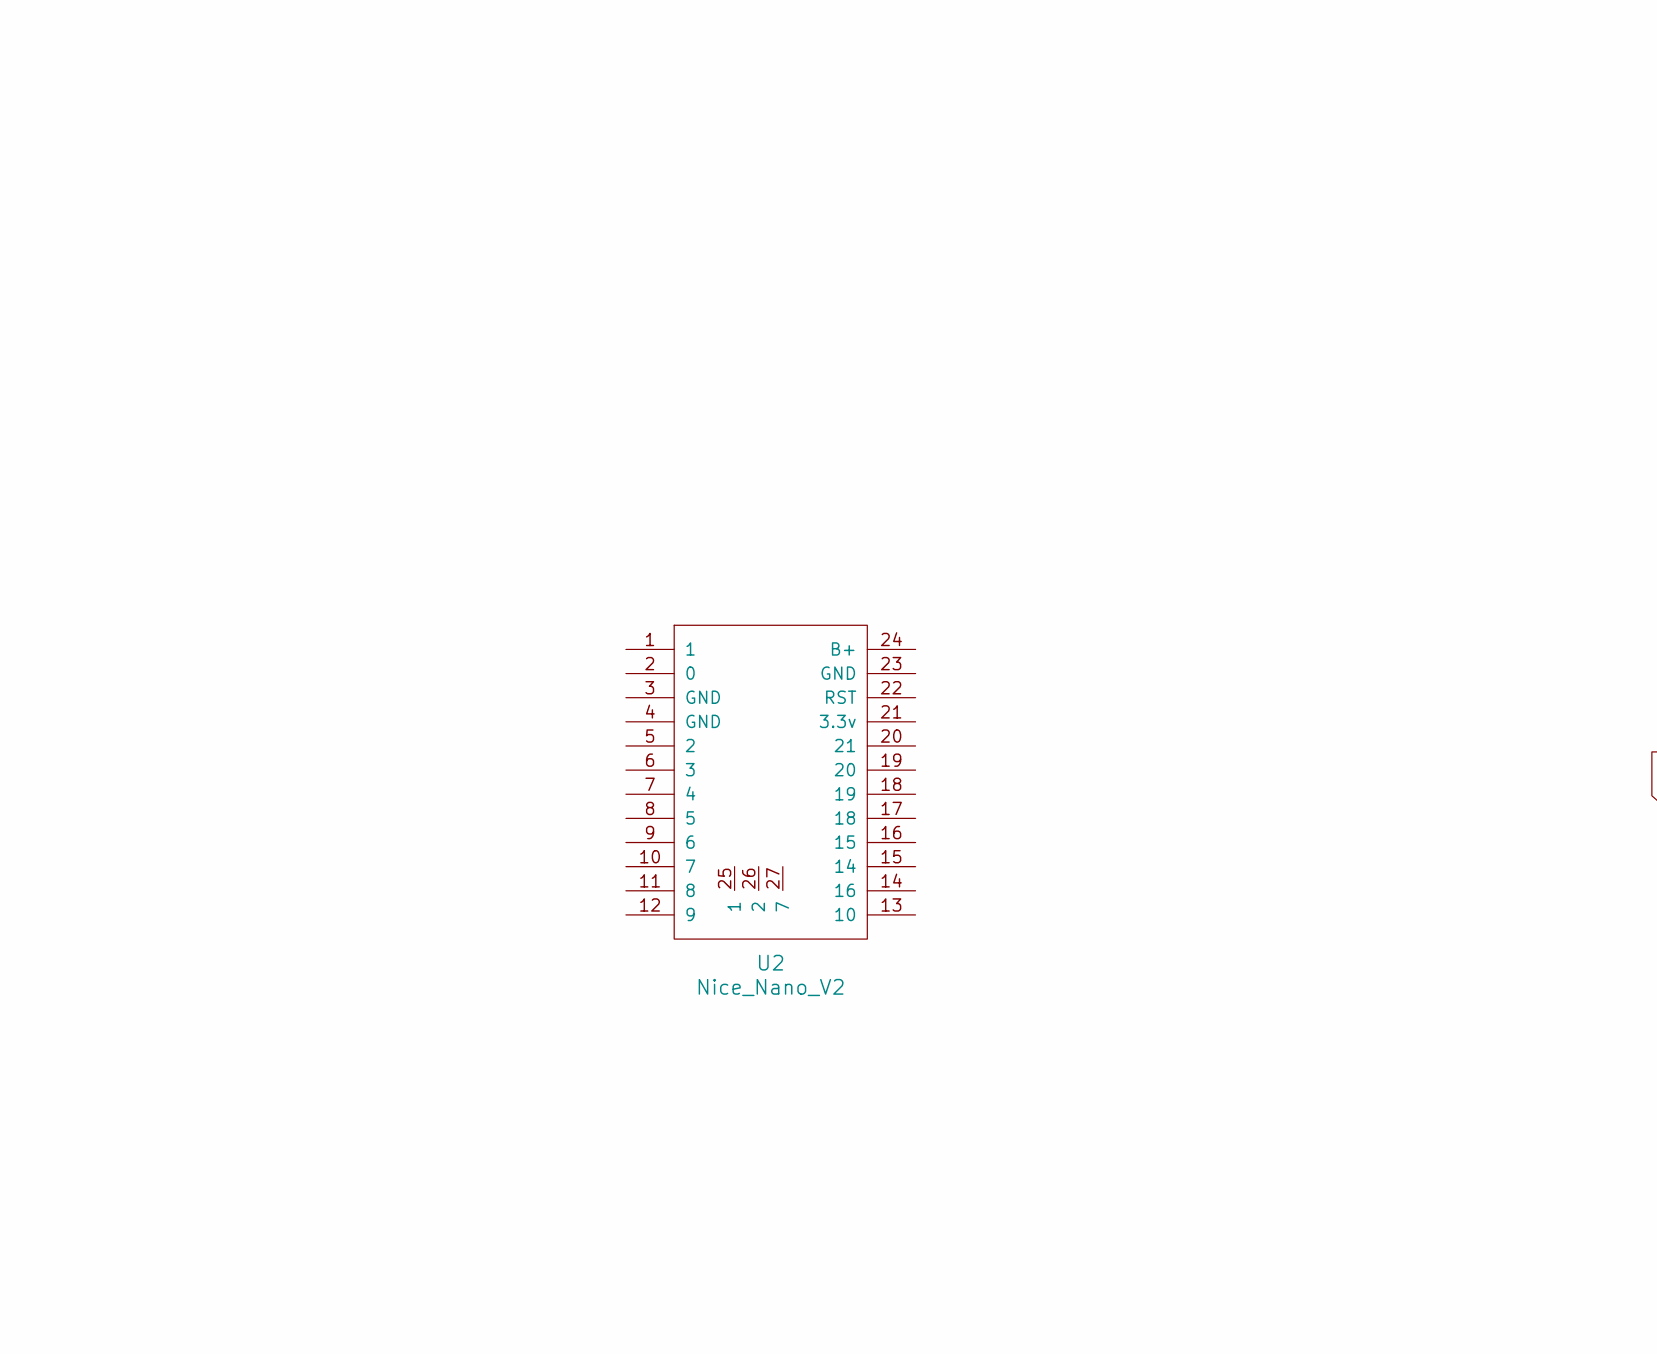
[picture p50: schematic left.kicad_sch, part in row 1, column 1]

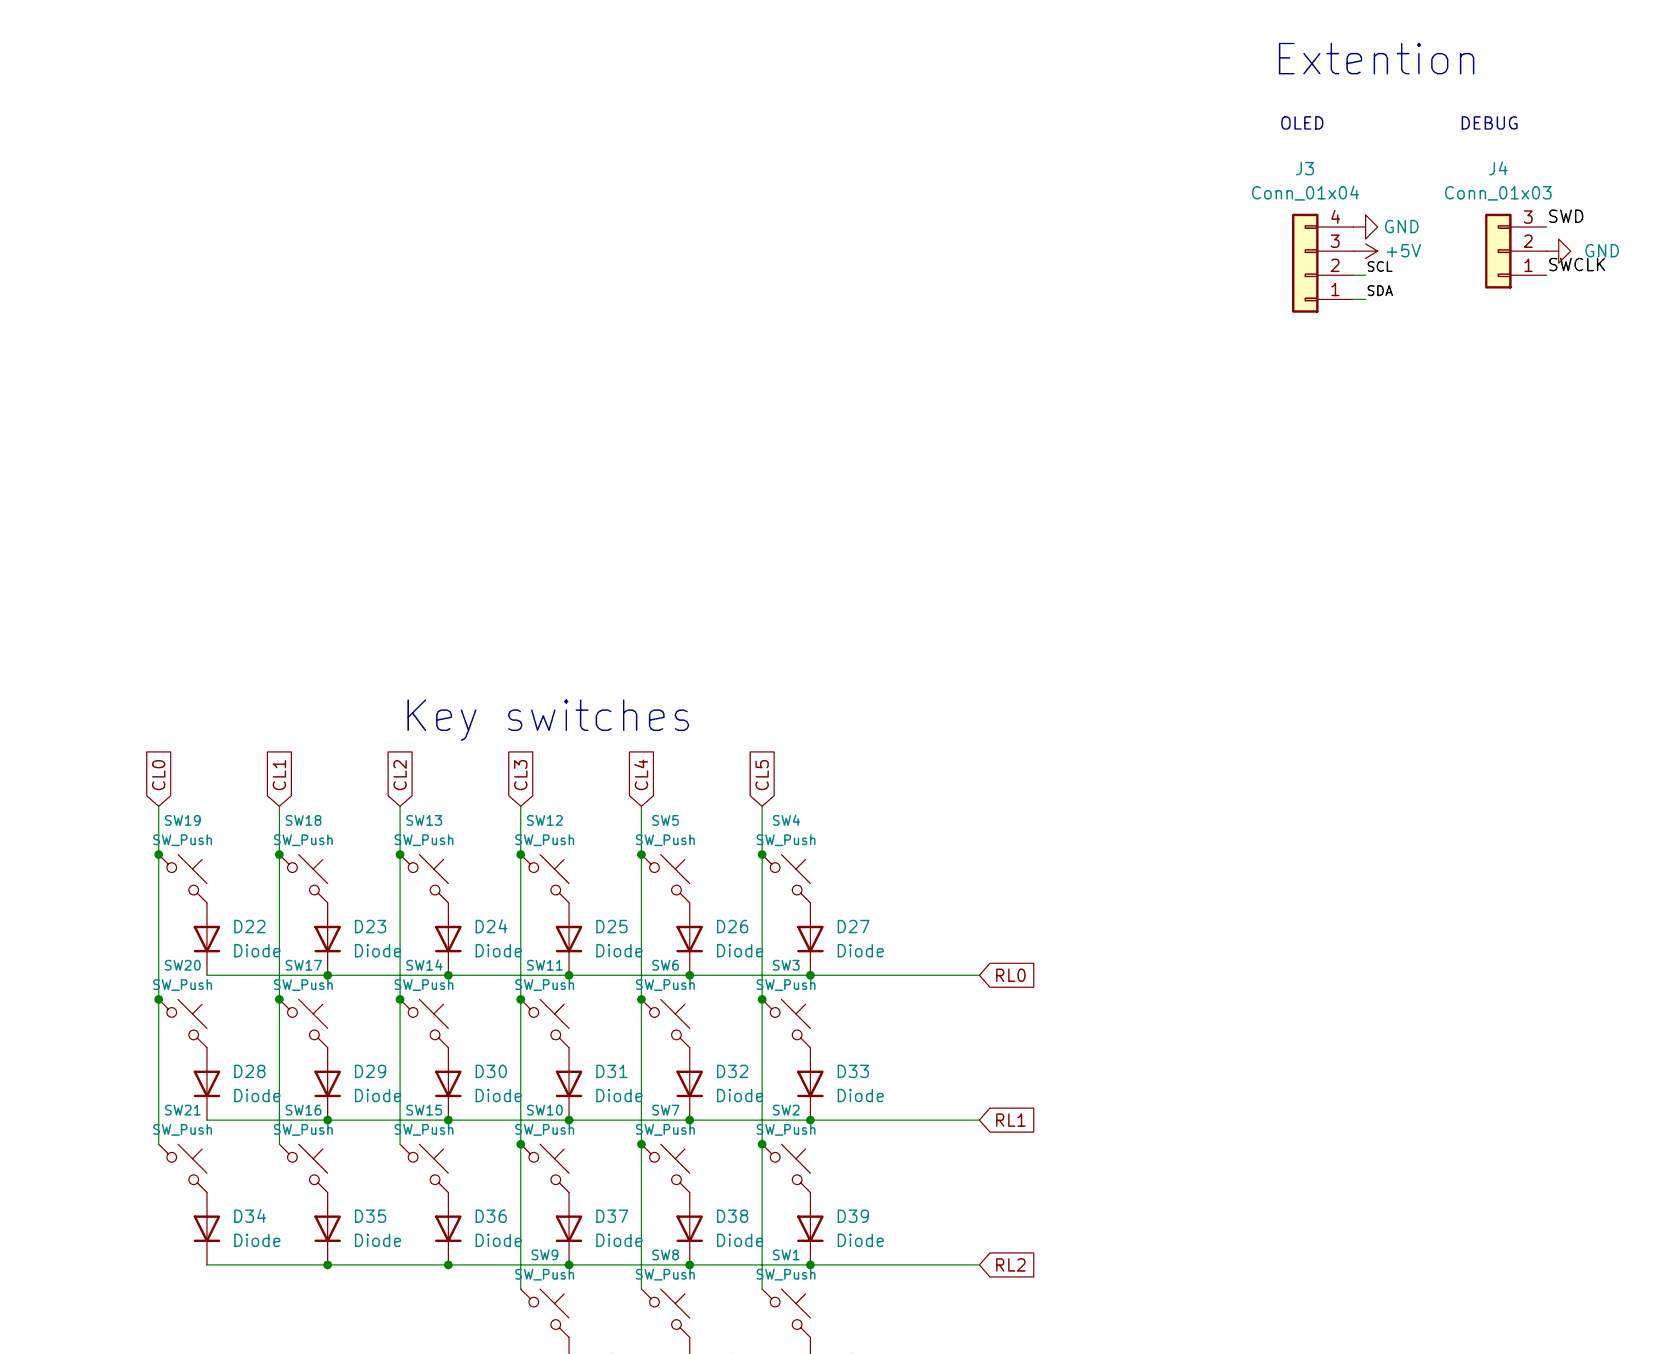
[picture p51: schematic left.kicad_sch, part in row 1, column 2]

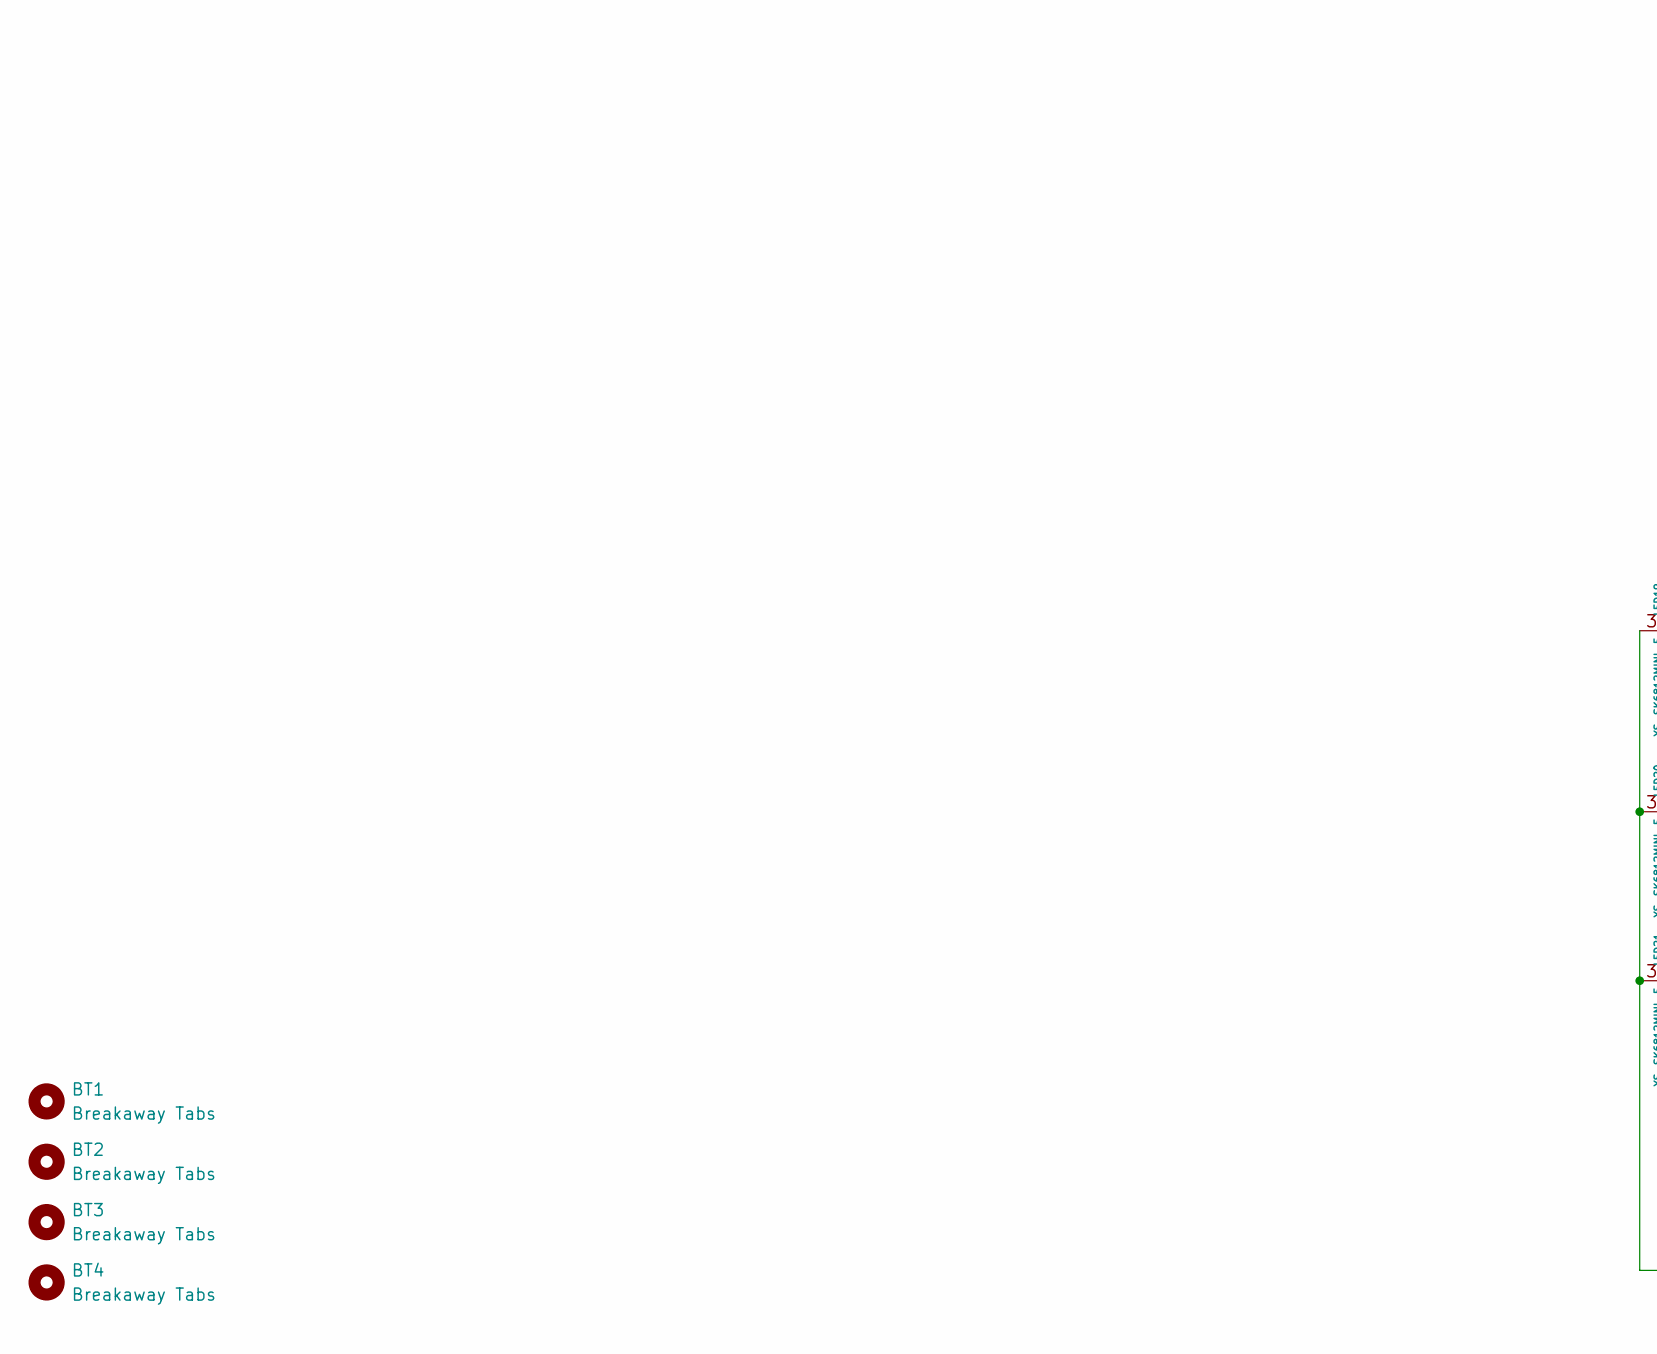
[picture p52: schematic left.kicad_sch, part in row 2, column 1]

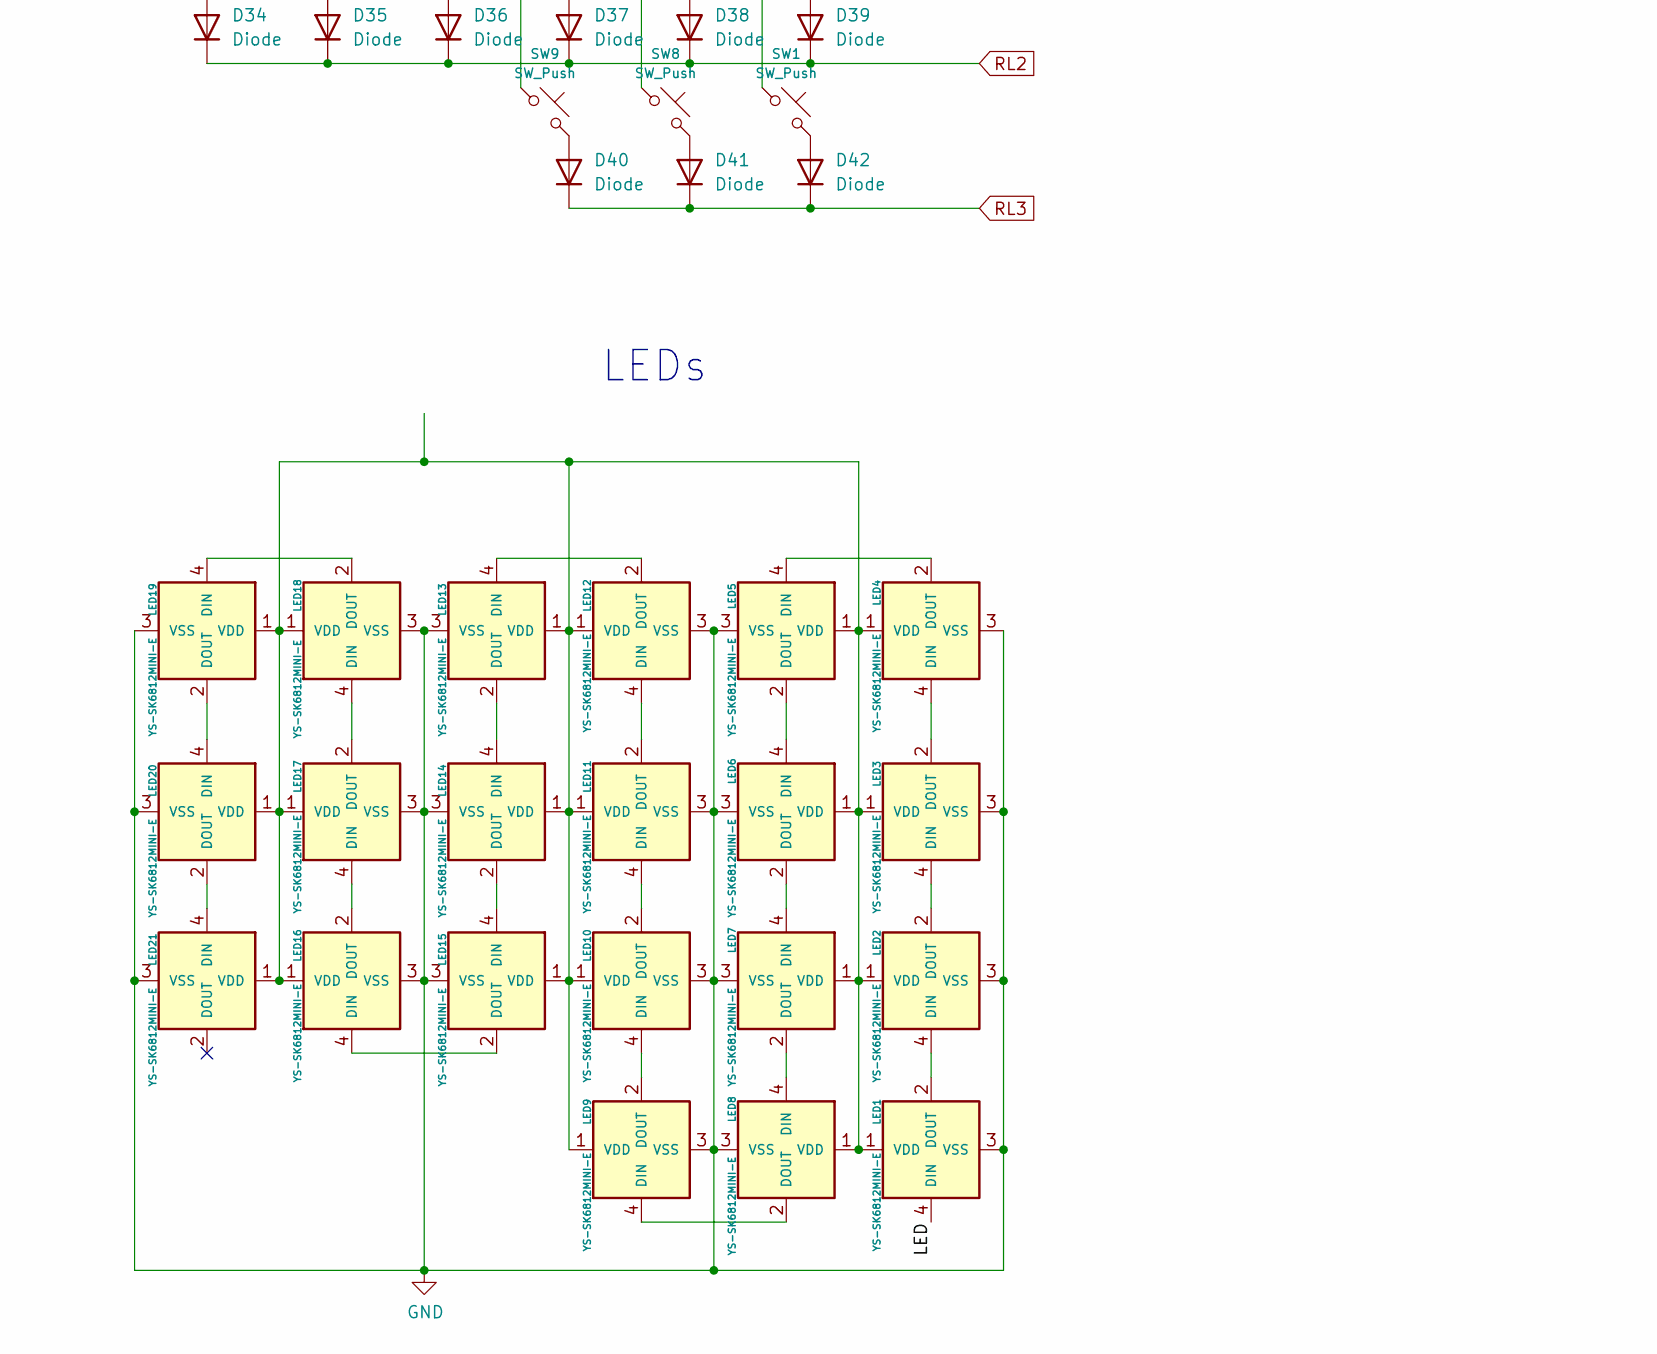
[picture p53: schematic left.kicad_sch, part in row 2, column 2]

Parts:
BT1, BT2, BT3, BT4: Breakaway Tabs; Breakaway_Tabs
D22, D23, D24, D25, D26, D27, D28, D29, D30, D31, D32, D33, D34, D35, D36, D37, D38, D39, D40, D41, D42: Diode; D_SOD-123
J3: Conn_01x04; OLED
J4: Conn_01x03; PinHeader_1x03_P2.54mm_Vertical
LED1, LED2, LED3, LED4, LED5, LED6, LED7, LED8, LED9, LED10, LED11, LED12, LED13, LED14, LED15, LED16, LED17, LED18, LED19, LED20, LED21: YS-SK6812MINI-E
SW1: SW_Push; keyswitch_cherrymx_hotswap_1.5u
SW2, SW3, SW4, SW5, SW6, SW7, SW8, SW9, SW10, SW11, SW12, SW13, SW14, SW15, SW16, SW17, SW18, SW19, SW20, SW21: SW_Push; keyswitch_cherrymx_hotswap_1u
U2: Nice_Nano_V2

Connections:
+5V: J3.3
CL0: SW19.1, SW20.1, SW21.1
CL1: SW16.1, SW17.1, SW18.1
CL2: SW13.1, SW14.1, SW15.1
CL3: SW9.1, SW10.1, SW11.1, SW12.1
CL4: SW5.1, SW6.1, SW7.1, SW8.1
CL5: SW1.1, SW2.1, SW3.1, SW4.1
GND: J3.4, J4.2, LED1.3 (VSS), LED2.3 (VSS), LED3.3 (VSS), LED4.3 (VSS), LED5.3 (VSS), LED6.3 (VSS), LED7.3 (VSS), LED8.3 (VSS), LED9.3 (VSS), LED10.3 (VSS), LED11.3 (VSS), LED12.3 (VSS), LED13.3 (VSS), LED14.3 (VSS), LED15.3 (VSS), LED16.3 (VSS), LED17.3 (VSS), LED18.3 (VSS), LED19.3 (VSS), LED20.3 (VSS), LED21.3 (VSS)
LED: LED1.4 (DIN)
unnamed: D22.2 (A), SW19.2
unnamed: D23.2 (A), SW18.2
unnamed: D24.2 (A), SW13.2
unnamed: D25.2 (A), SW12.2
unnamed: D26.2 (A), SW5.2
unnamed: D27.2 (A), SW4.2
unnamed: D28.2 (A), SW20.2
unnamed: D29.2 (A), SW17.2
unnamed: D30.2 (A), SW14.2
unnamed: D31.2 (A), SW11.2
unnamed: D32.2 (A), SW6.2
unnamed: D33.2 (A), SW3.2
unnamed: D34.2 (A), SW21.2
unnamed: D35.2 (A), SW16.2
unnamed: D36.2 (A), SW15.2
unnamed: D37.2 (A), SW10.2
unnamed: D38.2 (A), SW7.2
unnamed: D39.2 (A), SW2.2
unnamed: D40.2 (A), SW9.2
unnamed: D41.2 (A), SW8.2
unnamed: D42.2 (A), SW1.2
unnamed: LED1.1 (VDD), LED2.1 (VDD), LED3.1 (VDD), LED4.1 (VDD), LED5.1 (VDD), LED6.1 (VDD), LED7.1 (VDD), LED8.1 (VDD), LED9.1 (VDD), LED10.1 (VDD), LED11.1 (VDD), LED12.1 (VDD), LED13.1 (VDD), LED14.1 (VDD), LED15.1 (VDD), LED16.1 (VDD), LED17.1 (VDD), LED18.1 (VDD), LED19.1 (VDD), LED20.1 (VDD), LED21.1 (VDD)
unnamed: LED1.2 (DOUT), LED2.4 (DIN)
unnamed: LED2.2 (DOUT), LED3.4 (DIN)
unnamed: LED3.2 (DOUT), LED4.4 (DIN)
unnamed: LED4.2 (DOUT), LED5.4 (DIN)
unnamed: LED5.2 (DOUT), LED6.4 (DIN)
unnamed: LED6.2 (DOUT), LED7.4 (DIN)
unnamed: LED7.2 (DOUT), LED8.4 (DIN)
unnamed: LED8.2 (DOUT), LED9.4 (DIN)
unnamed: LED10.2 (DOUT), LED11.4 (DIN)
unnamed: LED9.2 (DOUT), LED10.4 (DIN)
unnamed: LED11.2 (DOUT), LED12.4 (DIN)
unnamed: LED12.2 (DOUT), LED13.4 (DIN)
unnamed: LED13.2 (DOUT), LED14.4 (DIN)
unnamed: LED14.2 (DOUT), LED15.4 (DIN)
unnamed: LED15.2 (DOUT), LED16.4 (DIN)
unnamed: LED16.2 (DOUT), LED17.4 (DIN)
unnamed: LED17.2 (DOUT), LED18.4 (DIN)
unnamed: LED18.2 (DOUT), LED19.4 (DIN)
unnamed: LED19.2 (DOUT), LED20.4 (DIN)
unnamed: LED20.2 (DOUT), LED21.4 (DIN)
RL0: D22.1 (K), D23.1 (K), D24.1 (K), D25.1 (K), D26.1 (K), D27.1 (K)
RL1: D28.1 (K), D29.1 (K), D30.1 (K), D31.1 (K), D32.1 (K), D33.1 (K)
RL2: D34.1 (K), D35.1 (K), D36.1 (K), D37.1 (K), D38.1 (K), D39.1 (K)
RL3: D40.1 (K), D41.1 (K), D42.1 (K)
SCL: J3.2
SDA: J3.1
SWCLK: J4.1
SWD: J4.3

Notes on the sheet:
Key switches
OLED
DEBUG
LEDs
Extention
