VladCher-ger/MyKeyBoard/crkbd/pcbs/common/right.kicad_sch

## KiCad design crkbd/pcbs/common/right.kicad_sch (2025-06-12)

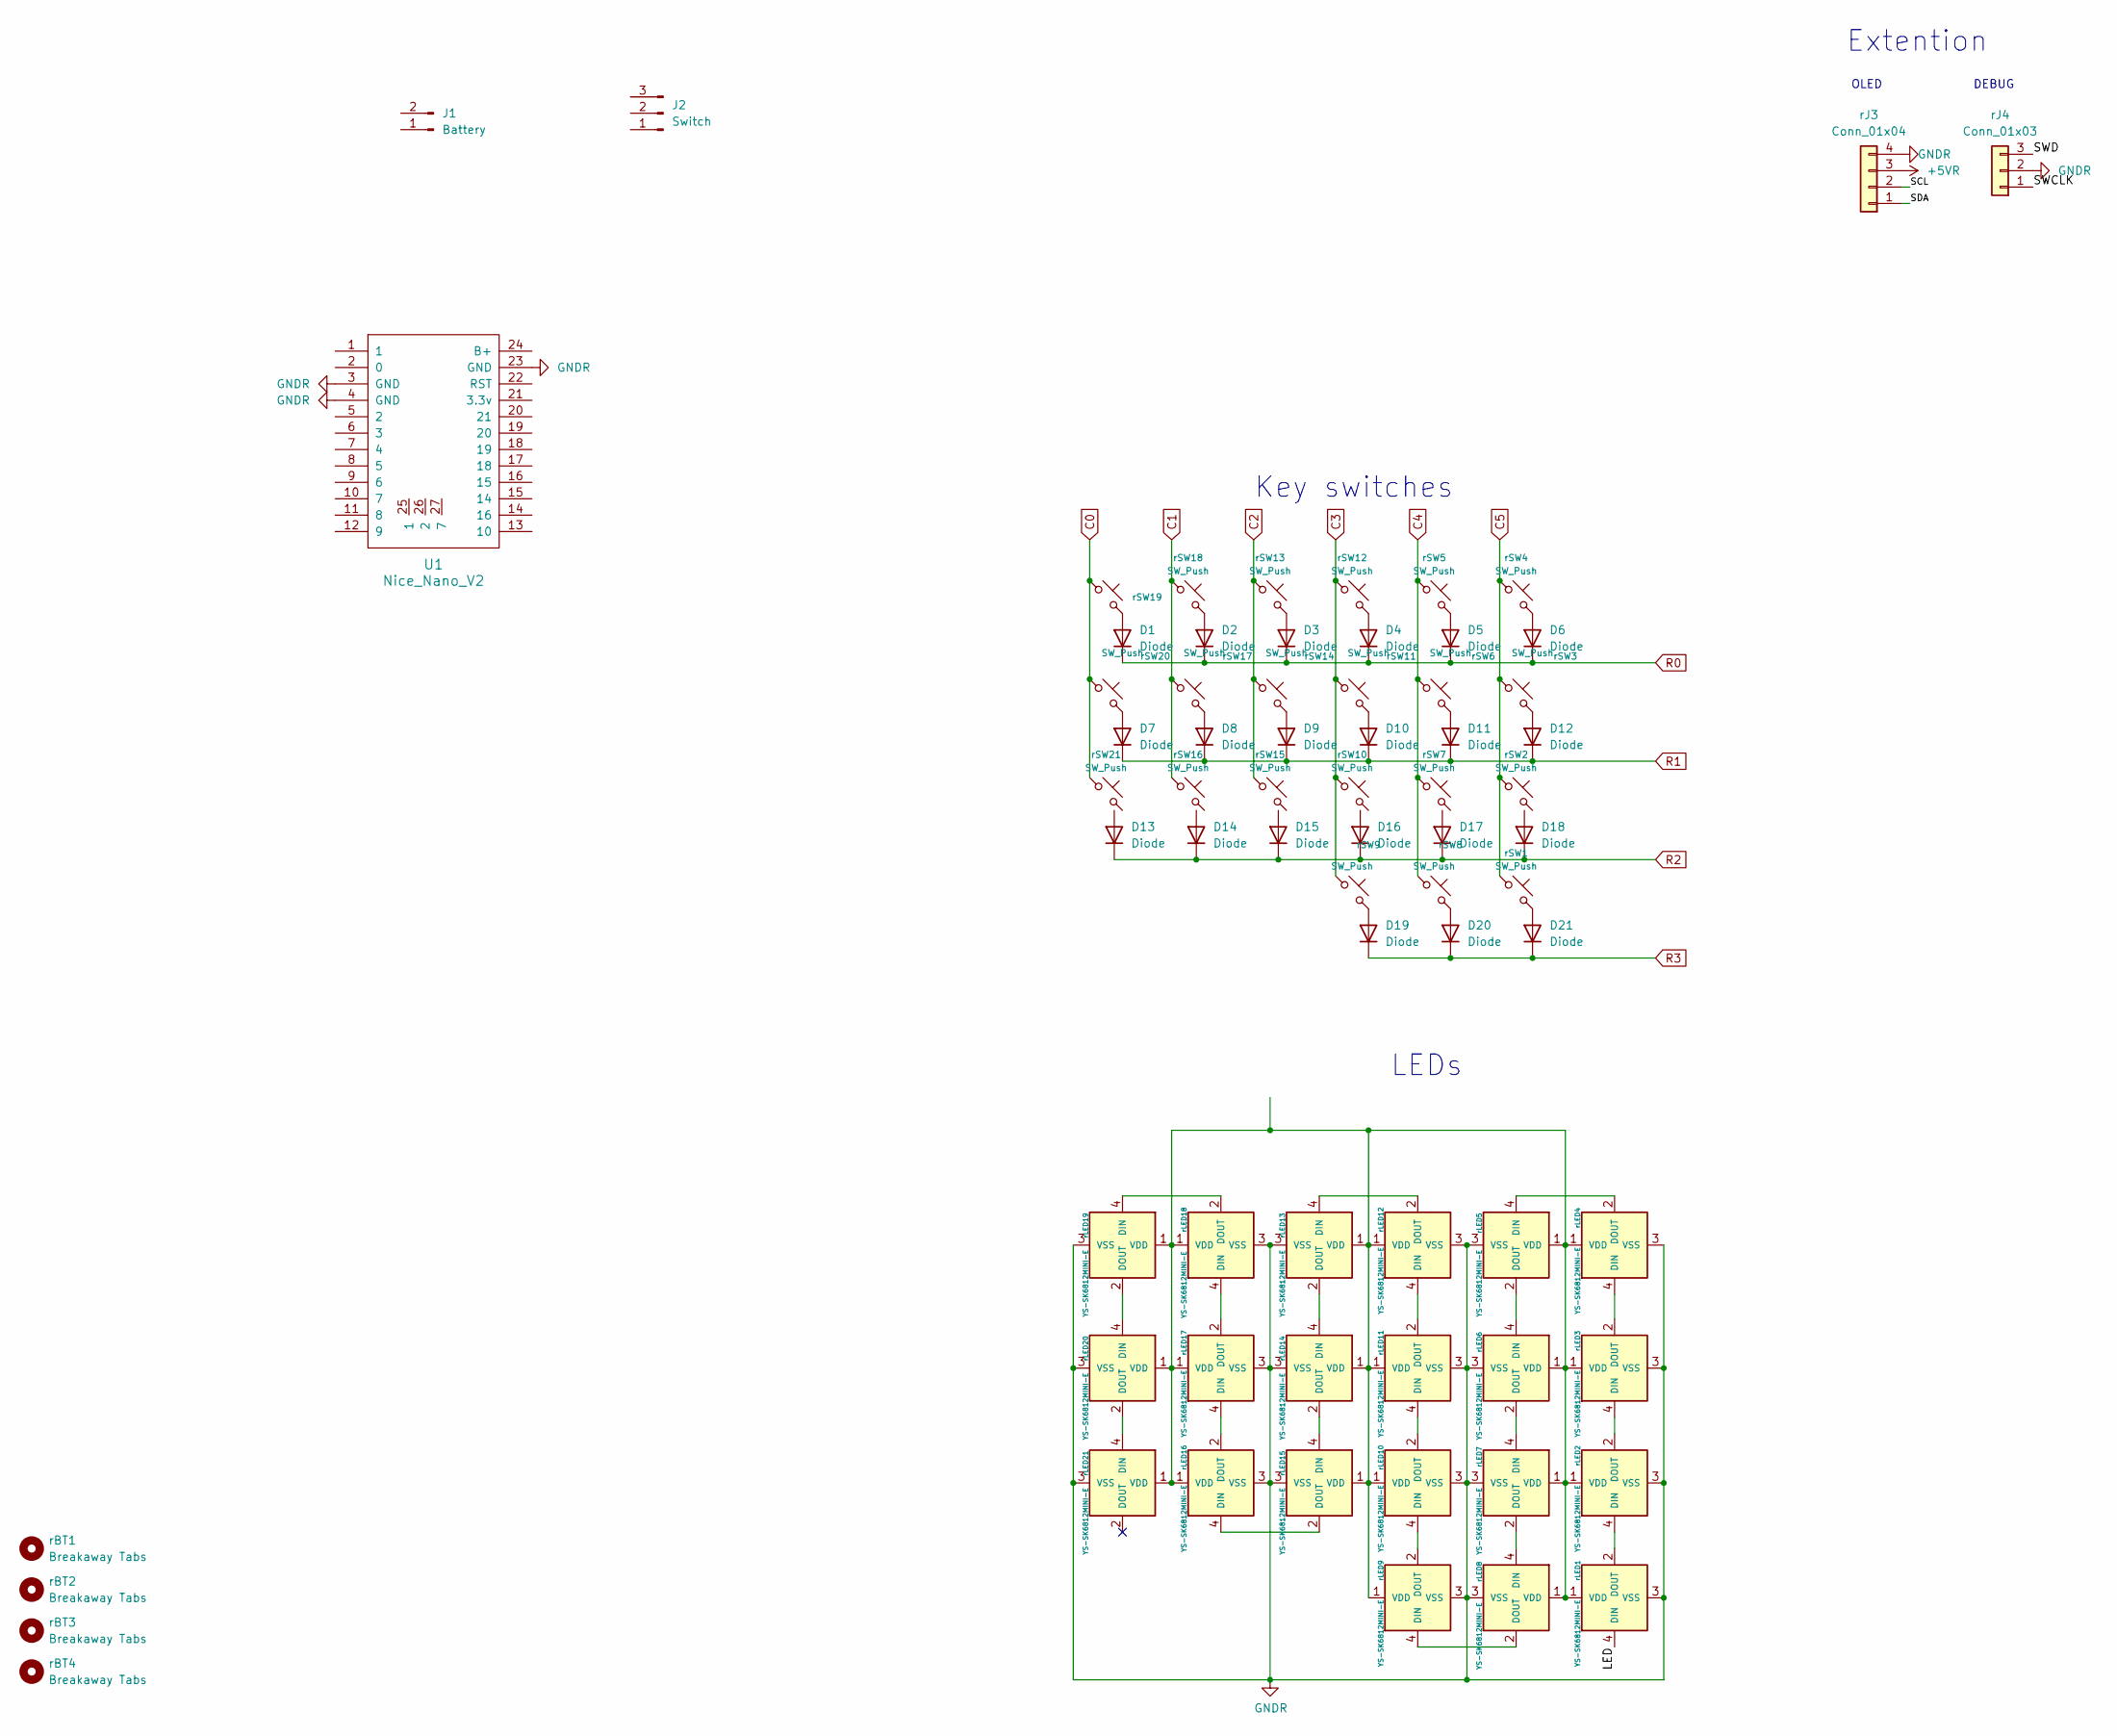
[picture p54: schematic right.kicad_sch]

Parts:
D1, D2, D3, D4, D5, D6, D7, D8, D9, D10, D11, D12, D13, D14, D15, D16, D17, D18, D19, D20, D21: Diode; D_SOD-123
J1: Battery
J2: Switch
U1: Nice_Nano_V2
rBT1, rBT2, rBT3, rBT4: Breakaway Tabs; Breakaway_Tabs
rJ3: Conn_01x04; OLED
rJ4: Conn_01x03; PinHeader_1x03_P2.54mm_Vertical
rLED1, rLED2, rLED3, rLED4, rLED5, rLED6, rLED7, rLED8, rLED9, rLED10, rLED11, rLED12, rLED13, rLED14, rLED15, rLED16, rLED17, rLED18, rLED19, rLED20, rLED21: YS-SK6812MINI-E
rSW1: SW_Push; keyswitch_cherrymx_hotswap_1.5u
rSW2, rSW3, rSW4, rSW5, rSW6, rSW7, rSW8, rSW9, rSW10, rSW11, rSW12, rSW13, rSW14, rSW15, rSW16, rSW17, rSW18, rSW19, rSW20, rSW21: SW_Push; keyswitch_cherrymx_hotswap_1u

Connections:
+5VR: rJ3.3
C0: rSW19.1, rSW20.1, rSW21.1
C1: rSW16.1, rSW17.1, rSW18.1
C2: rSW13.1, rSW14.1, rSW15.1
C3: rSW9.1, rSW10.1, rSW11.1, rSW12.1
C4: rSW5.1, rSW6.1, rSW7.1, rSW8.1
C5: rSW1.1, rSW2.1, rSW3.1, rSW4.1
GNDR: U1.3 (GND), U1.4 (GND), U1.23 (GND), rJ3.4, rJ4.2, rLED1.3 (VSS), rLED2.3 (VSS), rLED3.3 (VSS), rLED4.3 (VSS), rLED5.3 (VSS), rLED6.3 (VSS), rLED7.3 (VSS), rLED8.3 (VSS), rLED9.3 (VSS), rLED10.3 (VSS), rLED11.3 (VSS), rLED12.3 (VSS), rLED13.3 (VSS), rLED14.3 (VSS), rLED15.3 (VSS), rLED16.3 (VSS), rLED17.3 (VSS), rLED18.3 (VSS), rLED19.3 (VSS), rLED20.3 (VSS), rLED21.3 (VSS)
LED: rLED1.4 (DIN)
unnamed: D1.2 (A), rSW19.2
unnamed: D2.2 (A), rSW18.2
unnamed: D3.2 (A), rSW13.2
unnamed: D4.2 (A), rSW12.2
unnamed: D5.2 (A), rSW5.2
unnamed: D6.2 (A), rSW4.2
unnamed: D7.2 (A), rSW20.2
unnamed: D8.2 (A), rSW17.2
unnamed: D9.2 (A), rSW14.2
unnamed: D10.2 (A), rSW11.2
unnamed: D11.2 (A), rSW6.2
unnamed: D12.2 (A), rSW3.2
unnamed: D19.2 (A), rSW9.2
unnamed: D20.2 (A), rSW8.2
unnamed: D21.2 (A), rSW1.2
unnamed: rLED1.1 (VDD), rLED2.1 (VDD), rLED3.1 (VDD), rLED4.1 (VDD), rLED5.1 (VDD), rLED6.1 (VDD), rLED7.1 (VDD), rLED8.1 (VDD), rLED9.1 (VDD), rLED10.1 (VDD), rLED11.1 (VDD), rLED12.1 (VDD), rLED13.1 (VDD), rLED14.1 (VDD), rLED15.1 (VDD), rLED16.1 (VDD), rLED17.1 (VDD), rLED18.1 (VDD), rLED19.1 (VDD), rLED20.1 (VDD), rLED21.1 (VDD)
unnamed: rLED1.2 (DOUT), rLED2.4 (DIN)
unnamed: rLED2.2 (DOUT), rLED3.4 (DIN)
unnamed: rLED3.2 (DOUT), rLED4.4 (DIN)
unnamed: rLED4.2 (DOUT), rLED5.4 (DIN)
unnamed: rLED5.2 (DOUT), rLED6.4 (DIN)
unnamed: rLED6.2 (DOUT), rLED7.4 (DIN)
unnamed: rLED7.2 (DOUT), rLED8.4 (DIN)
unnamed: rLED8.2 (DOUT), rLED9.4 (DIN)
unnamed: rLED10.2 (DOUT), rLED11.4 (DIN)
unnamed: rLED9.2 (DOUT), rLED10.4 (DIN)
unnamed: rLED11.2 (DOUT), rLED12.4 (DIN)
unnamed: rLED12.2 (DOUT), rLED13.4 (DIN)
unnamed: rLED13.2 (DOUT), rLED14.4 (DIN)
unnamed: rLED14.2 (DOUT), rLED15.4 (DIN)
unnamed: rLED15.2 (DOUT), rLED16.4 (DIN)
unnamed: rLED16.2 (DOUT), rLED17.4 (DIN)
unnamed: rLED17.2 (DOUT), rLED18.4 (DIN)
unnamed: rLED18.2 (DOUT), rLED19.4 (DIN)
unnamed: rLED19.2 (DOUT), rLED20.4 (DIN)
unnamed: rLED20.2 (DOUT), rLED21.4 (DIN)
R0: D1.1 (K), D2.1 (K), D3.1 (K), D4.1 (K), D5.1 (K), D6.1 (K)
R1: D7.1 (K), D8.1 (K), D9.1 (K), D10.1 (K), D11.1 (K), D12.1 (K)
R2: D13.1 (K), D14.1 (K), D15.1 (K), D16.1 (K), D17.1 (K), D18.1 (K)
R3: D19.1 (K), D20.1 (K), D21.1 (K)
SCL: rJ3.2
SDA: rJ3.1
SWCLK: rJ4.1
SWD: rJ4.3

Notes on the sheet:
DEBUG
Key switches
LEDs
Extention
OLED
