VladCher-ger/MyKeyBoard/(commit log)

2025-06-11 Left almost ready
    [Schaltplan.kicad_pcb, Schaltplan.kicad_sch, led.kicad_sch, left.kicad_pcb, left.kicad_sch, untitled.kicad_sch]
2025-06-12 custom crbd
    [BOM-corne-cherry.csv, BOM-corne-chocolate.csv, corne-cherry.kicad_pcb, corne-cherry.kicad_sch, corne-chocolate.kicad_pcb, corne-chocolate.kicad_sch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]
